bareboat-necessities/bbn_sensors_hub_C/img/bbn_engine_sensors_1.jpg

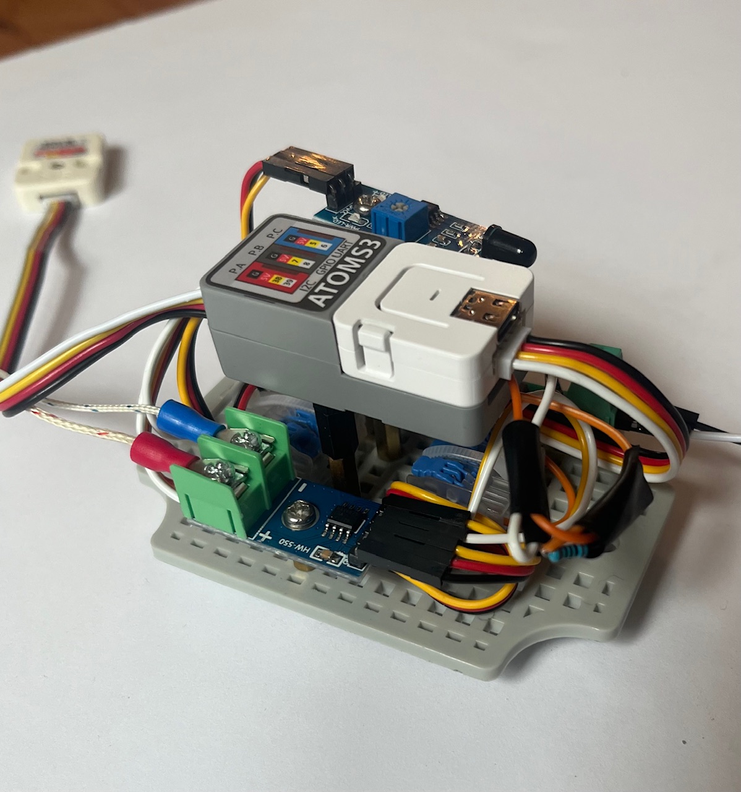
img/bbn_engine_sensors_1.jpg
