bareboat-necessities/bbn_sensors_hub_C/img/bbn_engine_sensors_2.jpg

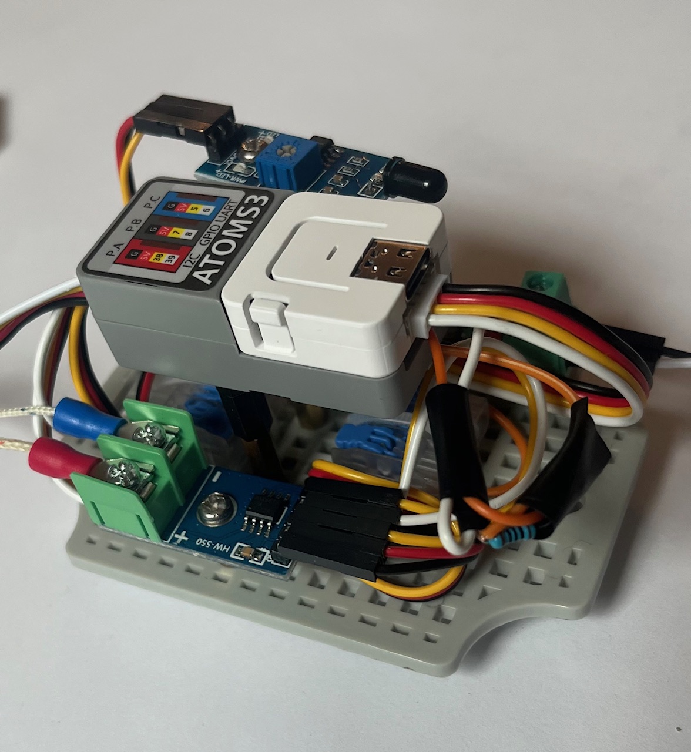
img/bbn_engine_sensors_2.jpg
