bareboat-necessities/bbn_sensors_hub_C/img/bbn_engine_sensors_3_3v.jpg

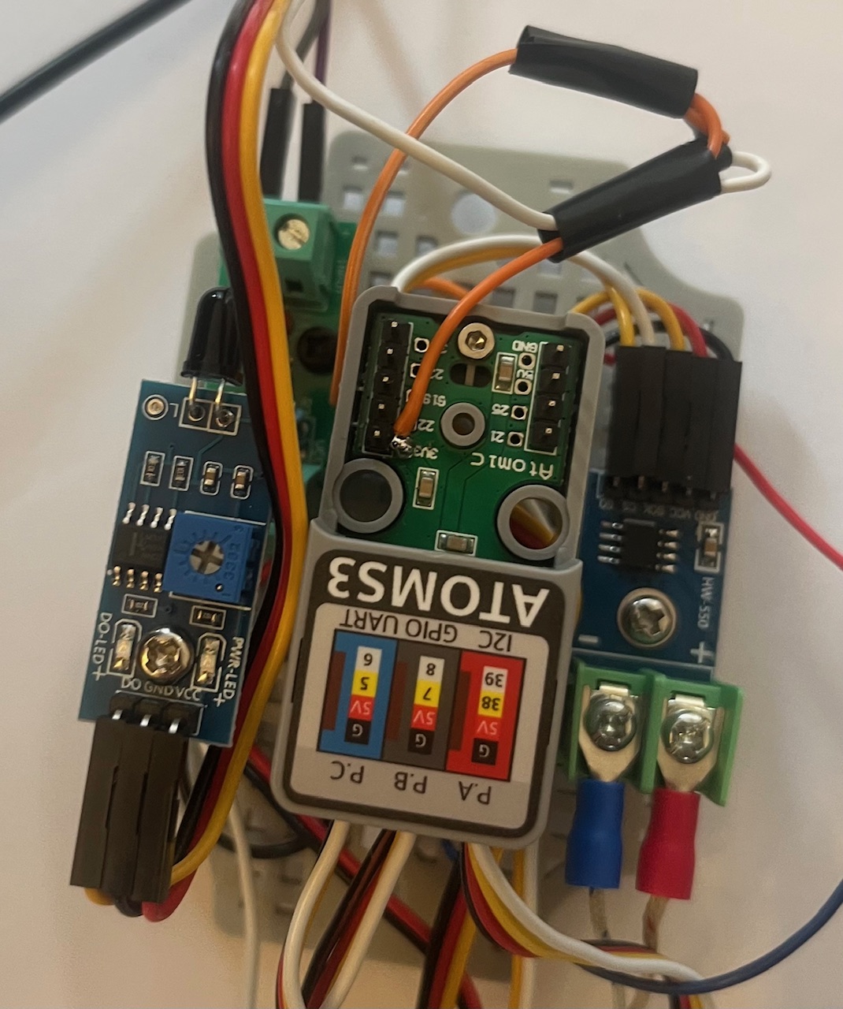
img/bbn_engine_sensors_3_3v.jpg
